eSpark-Backup/anthony-arii-bento-pad/Design Files/Bento Pad Plus V1.0/Schematic/Bento Pad Plus V1.0.pdf

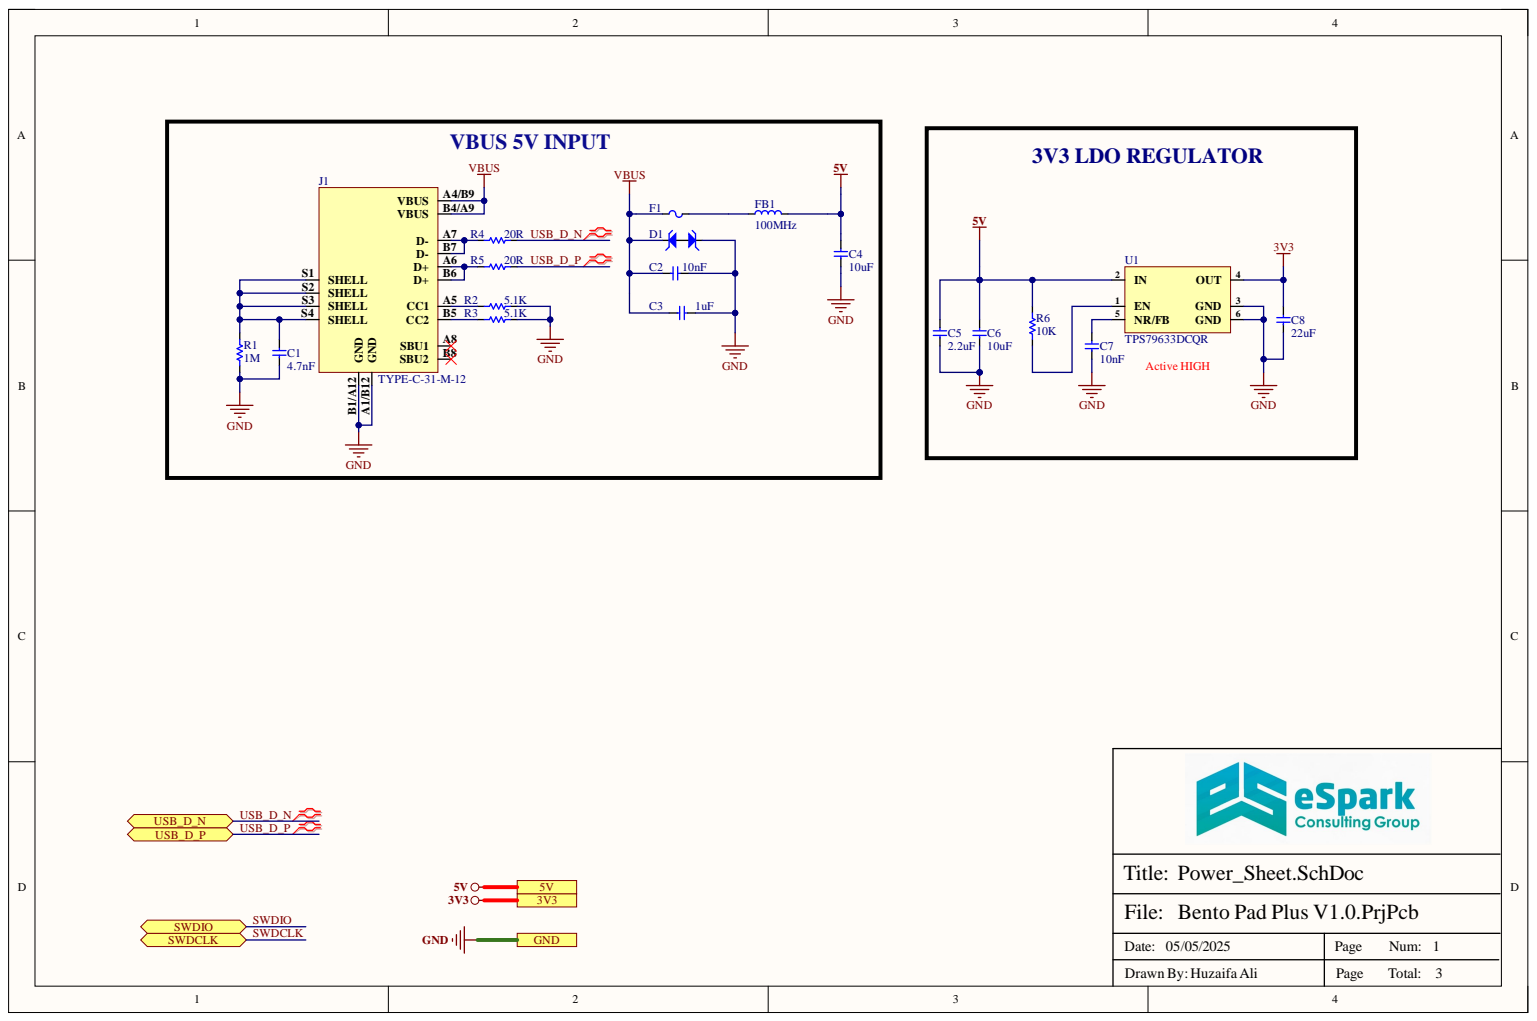
[picture p5: page 1]

Bento Pad Plus V1.0.PrjPcb

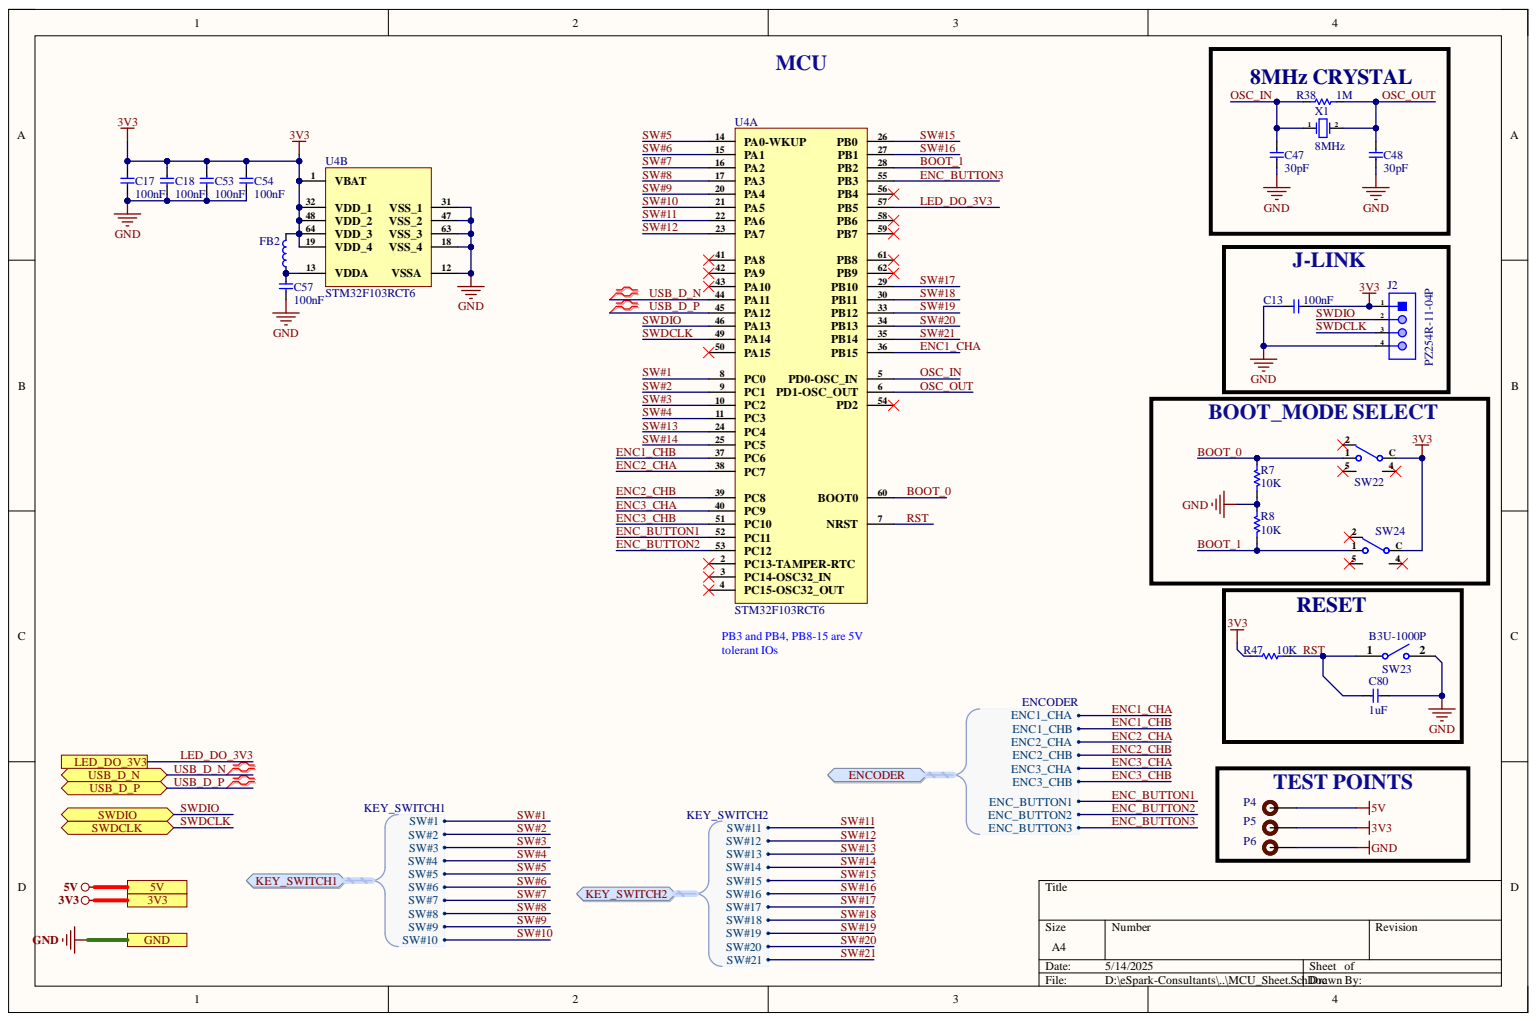
[picture p6: page 2]

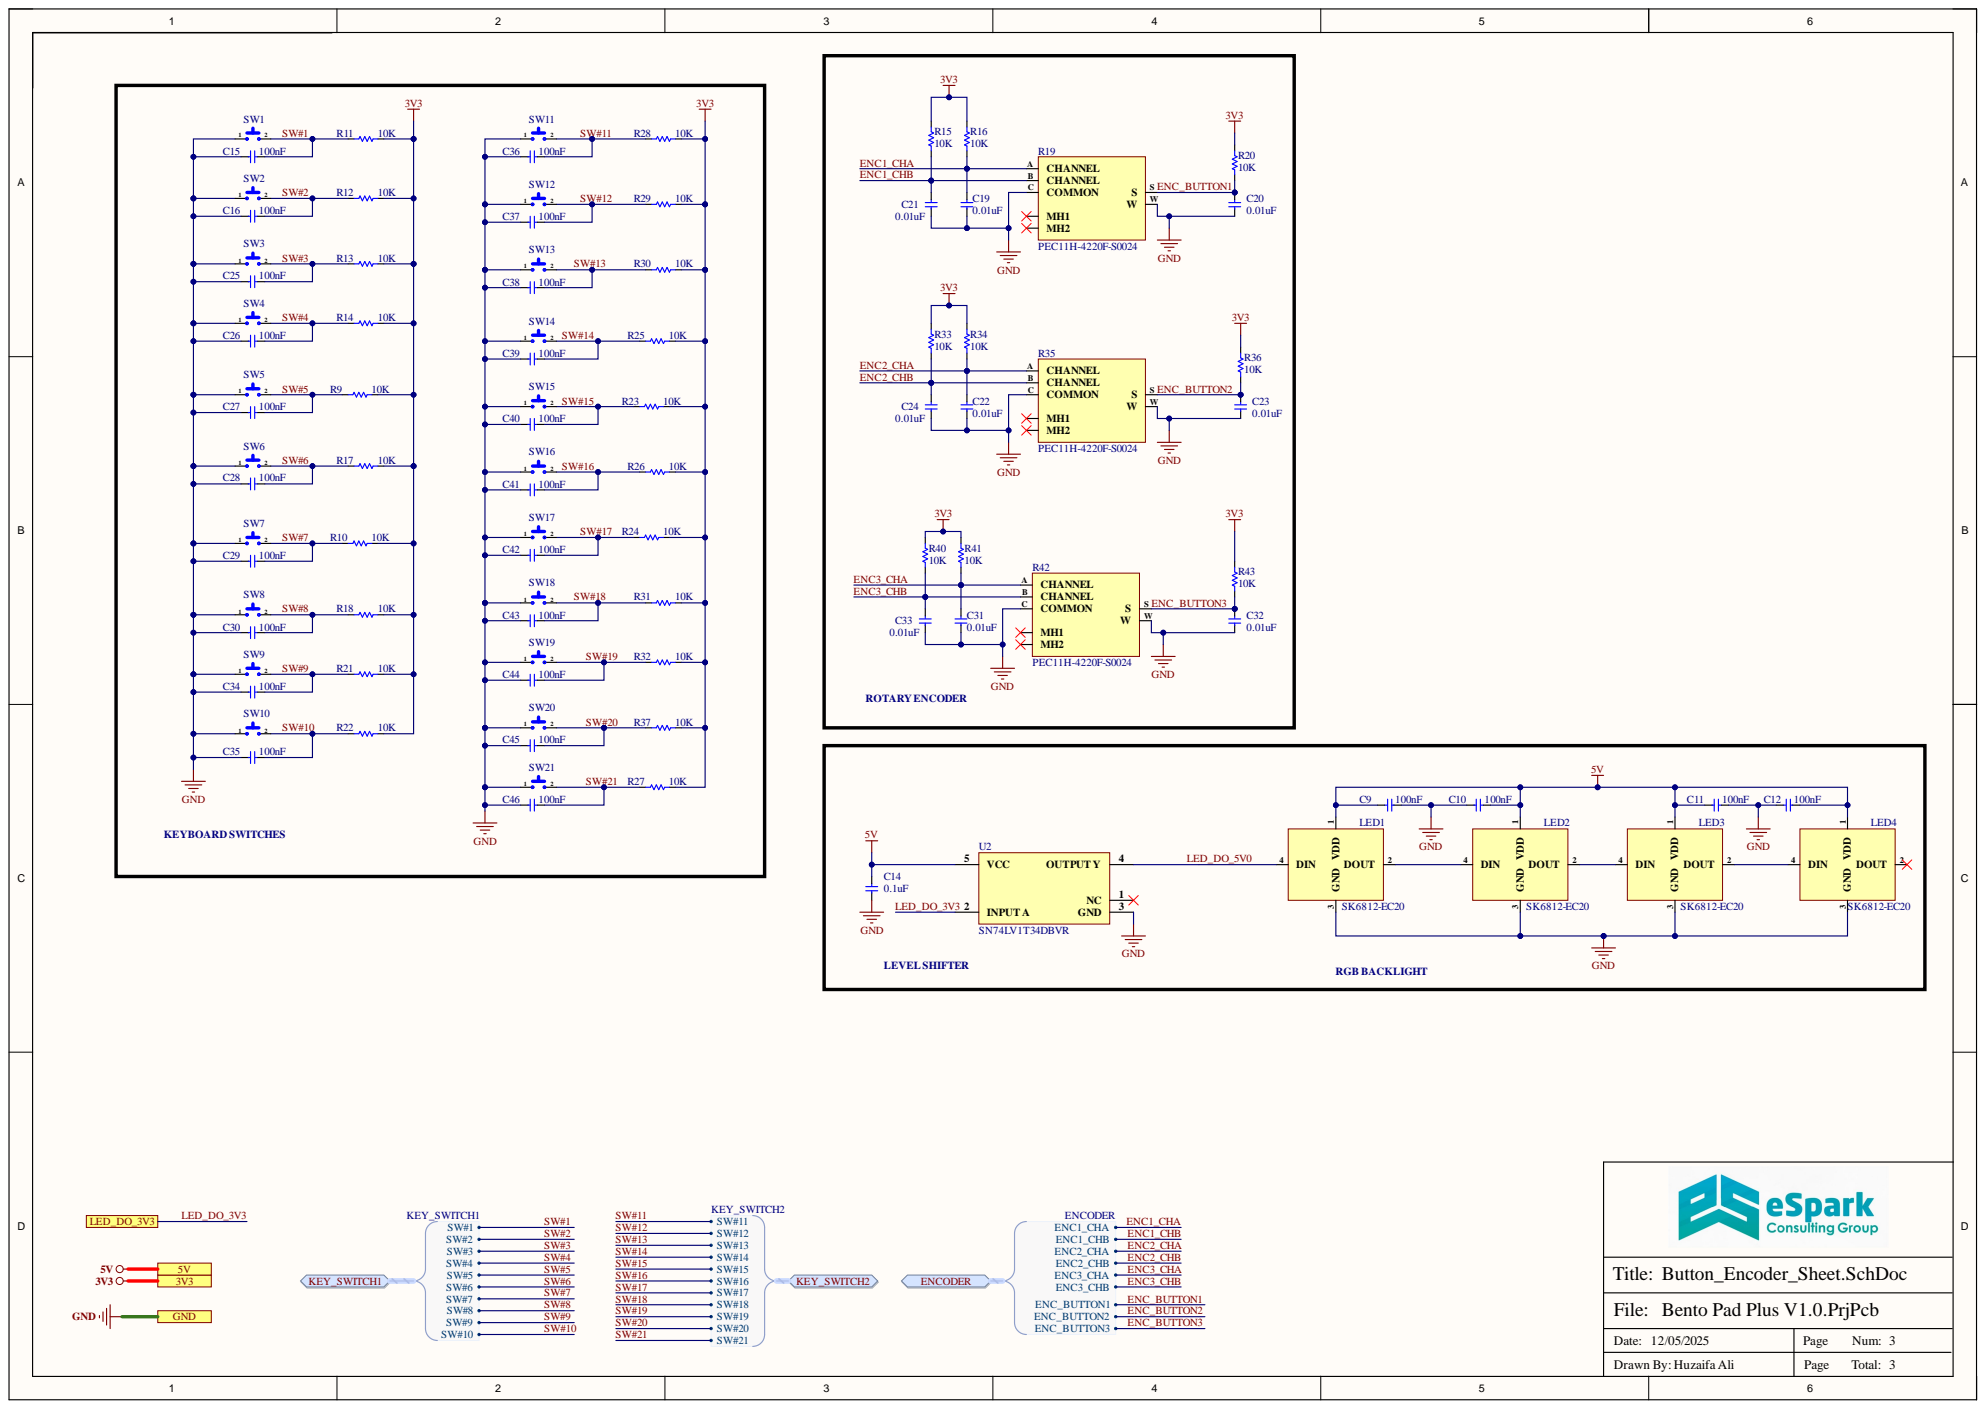
[picture p7: page 3]

Bento Pad Plus V1.0.PrjPcb

Date: 12/05/2025 | Page Num: 3

Drawn By: Huzaifa Ali | Page Total:
