eSpark-Backup/anthony-arii-bento-pad/Design Files/Bento Pad V1.0/Schematic/Bento Pad V1.0.pdf

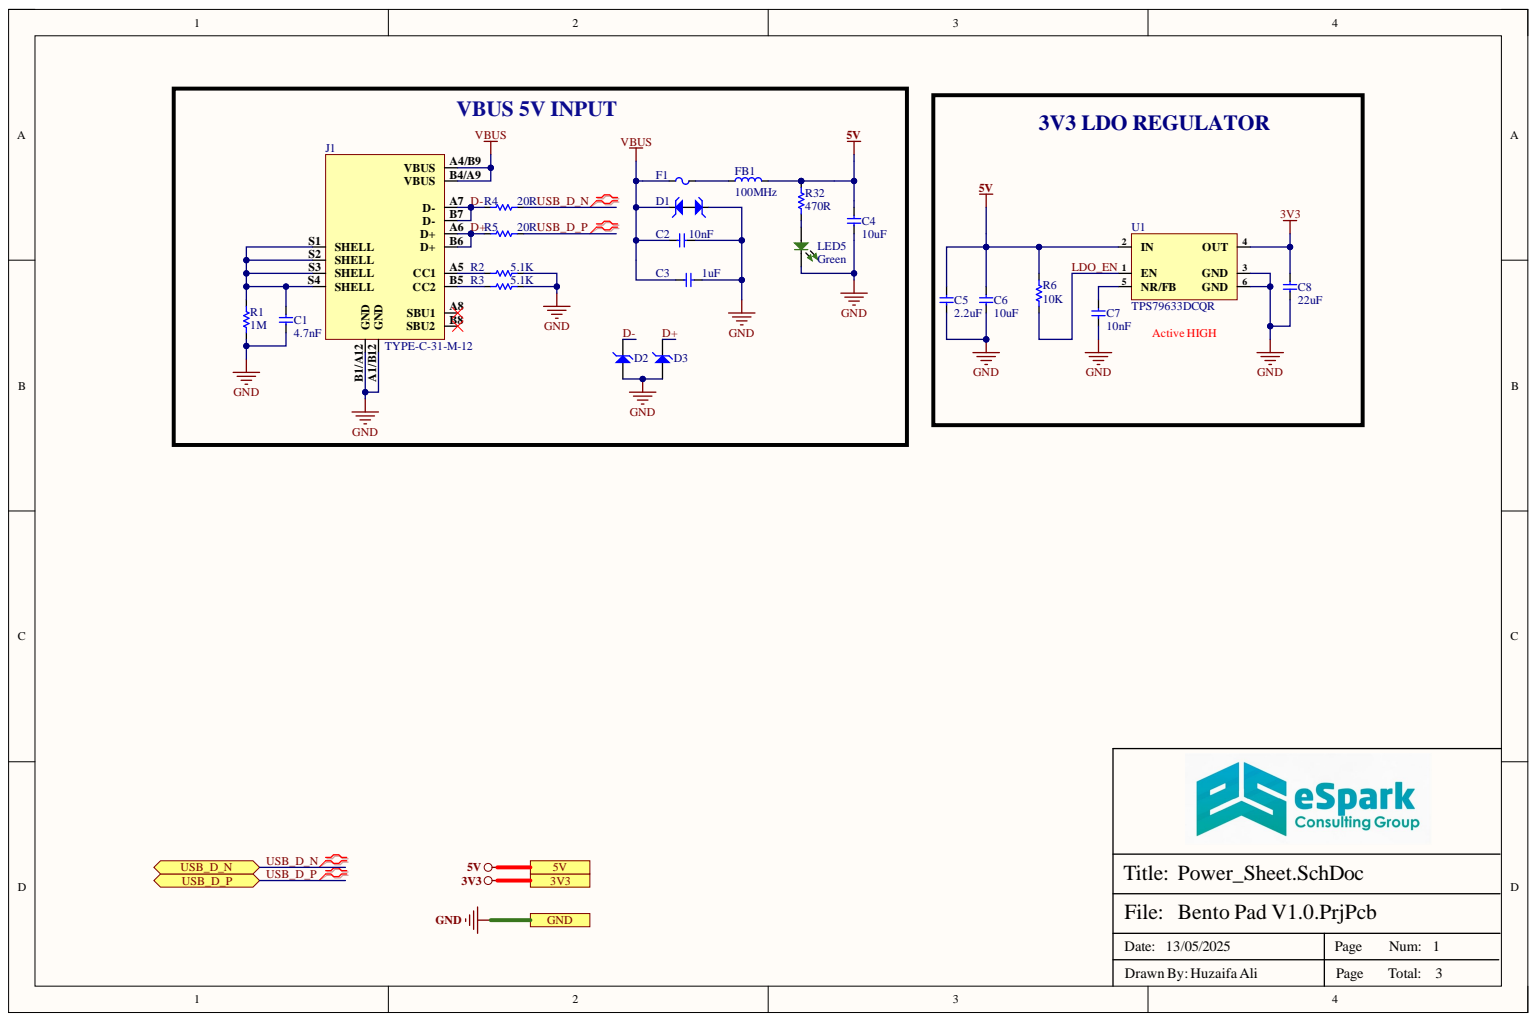
[picture p8: page 1]

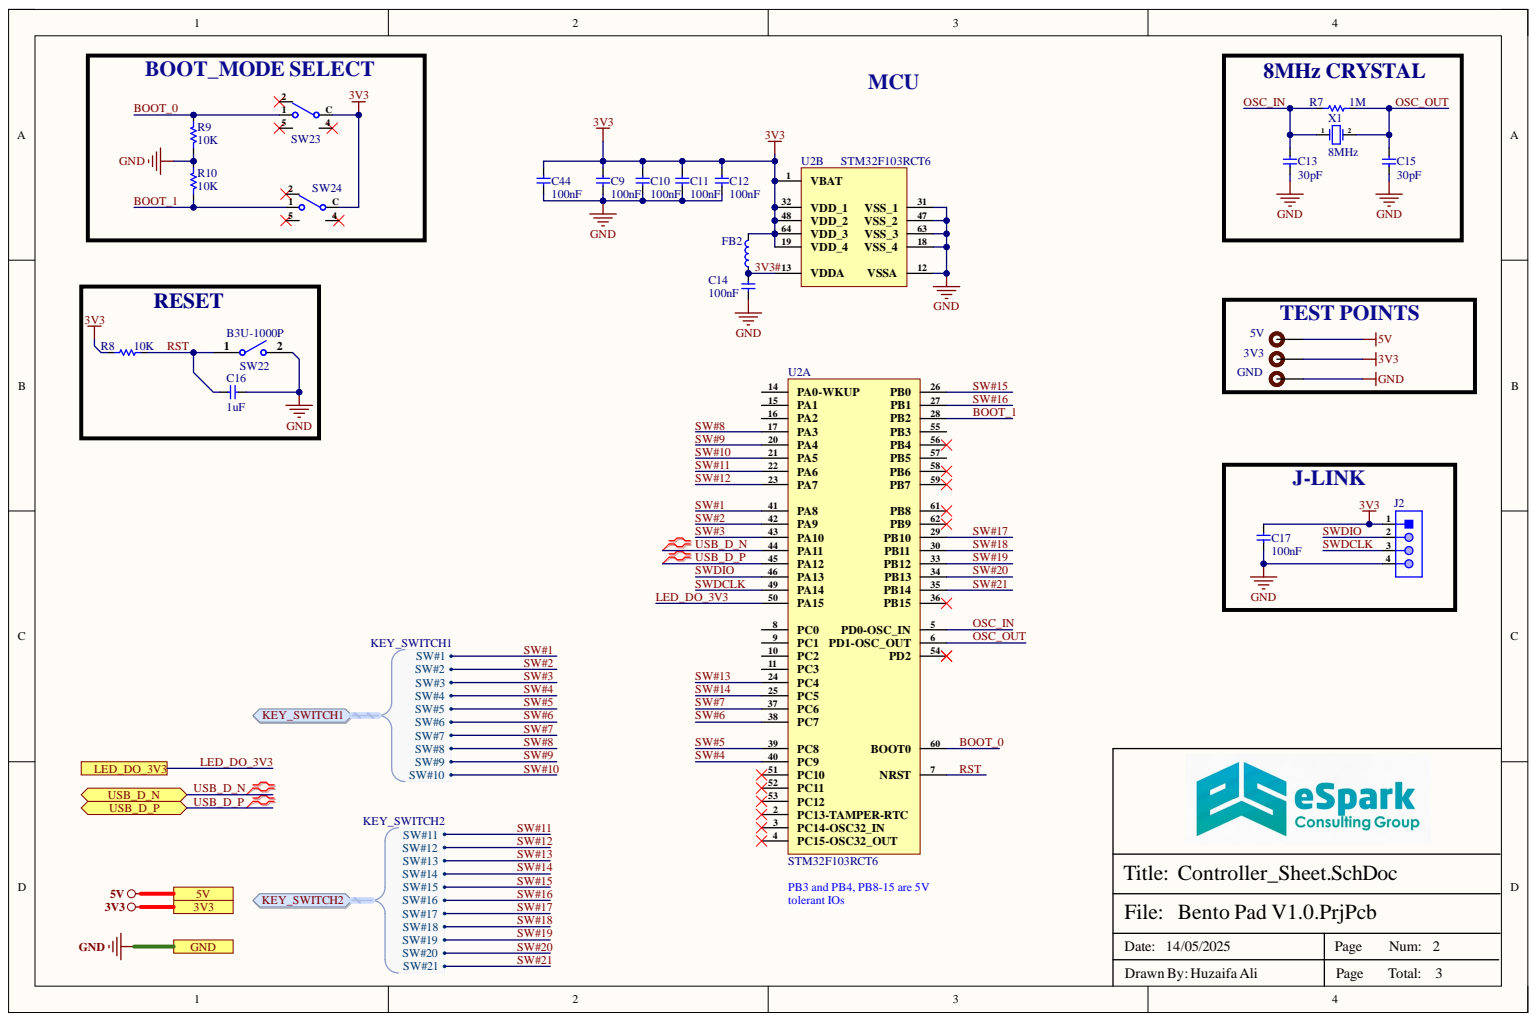
[picture p9: page 2]

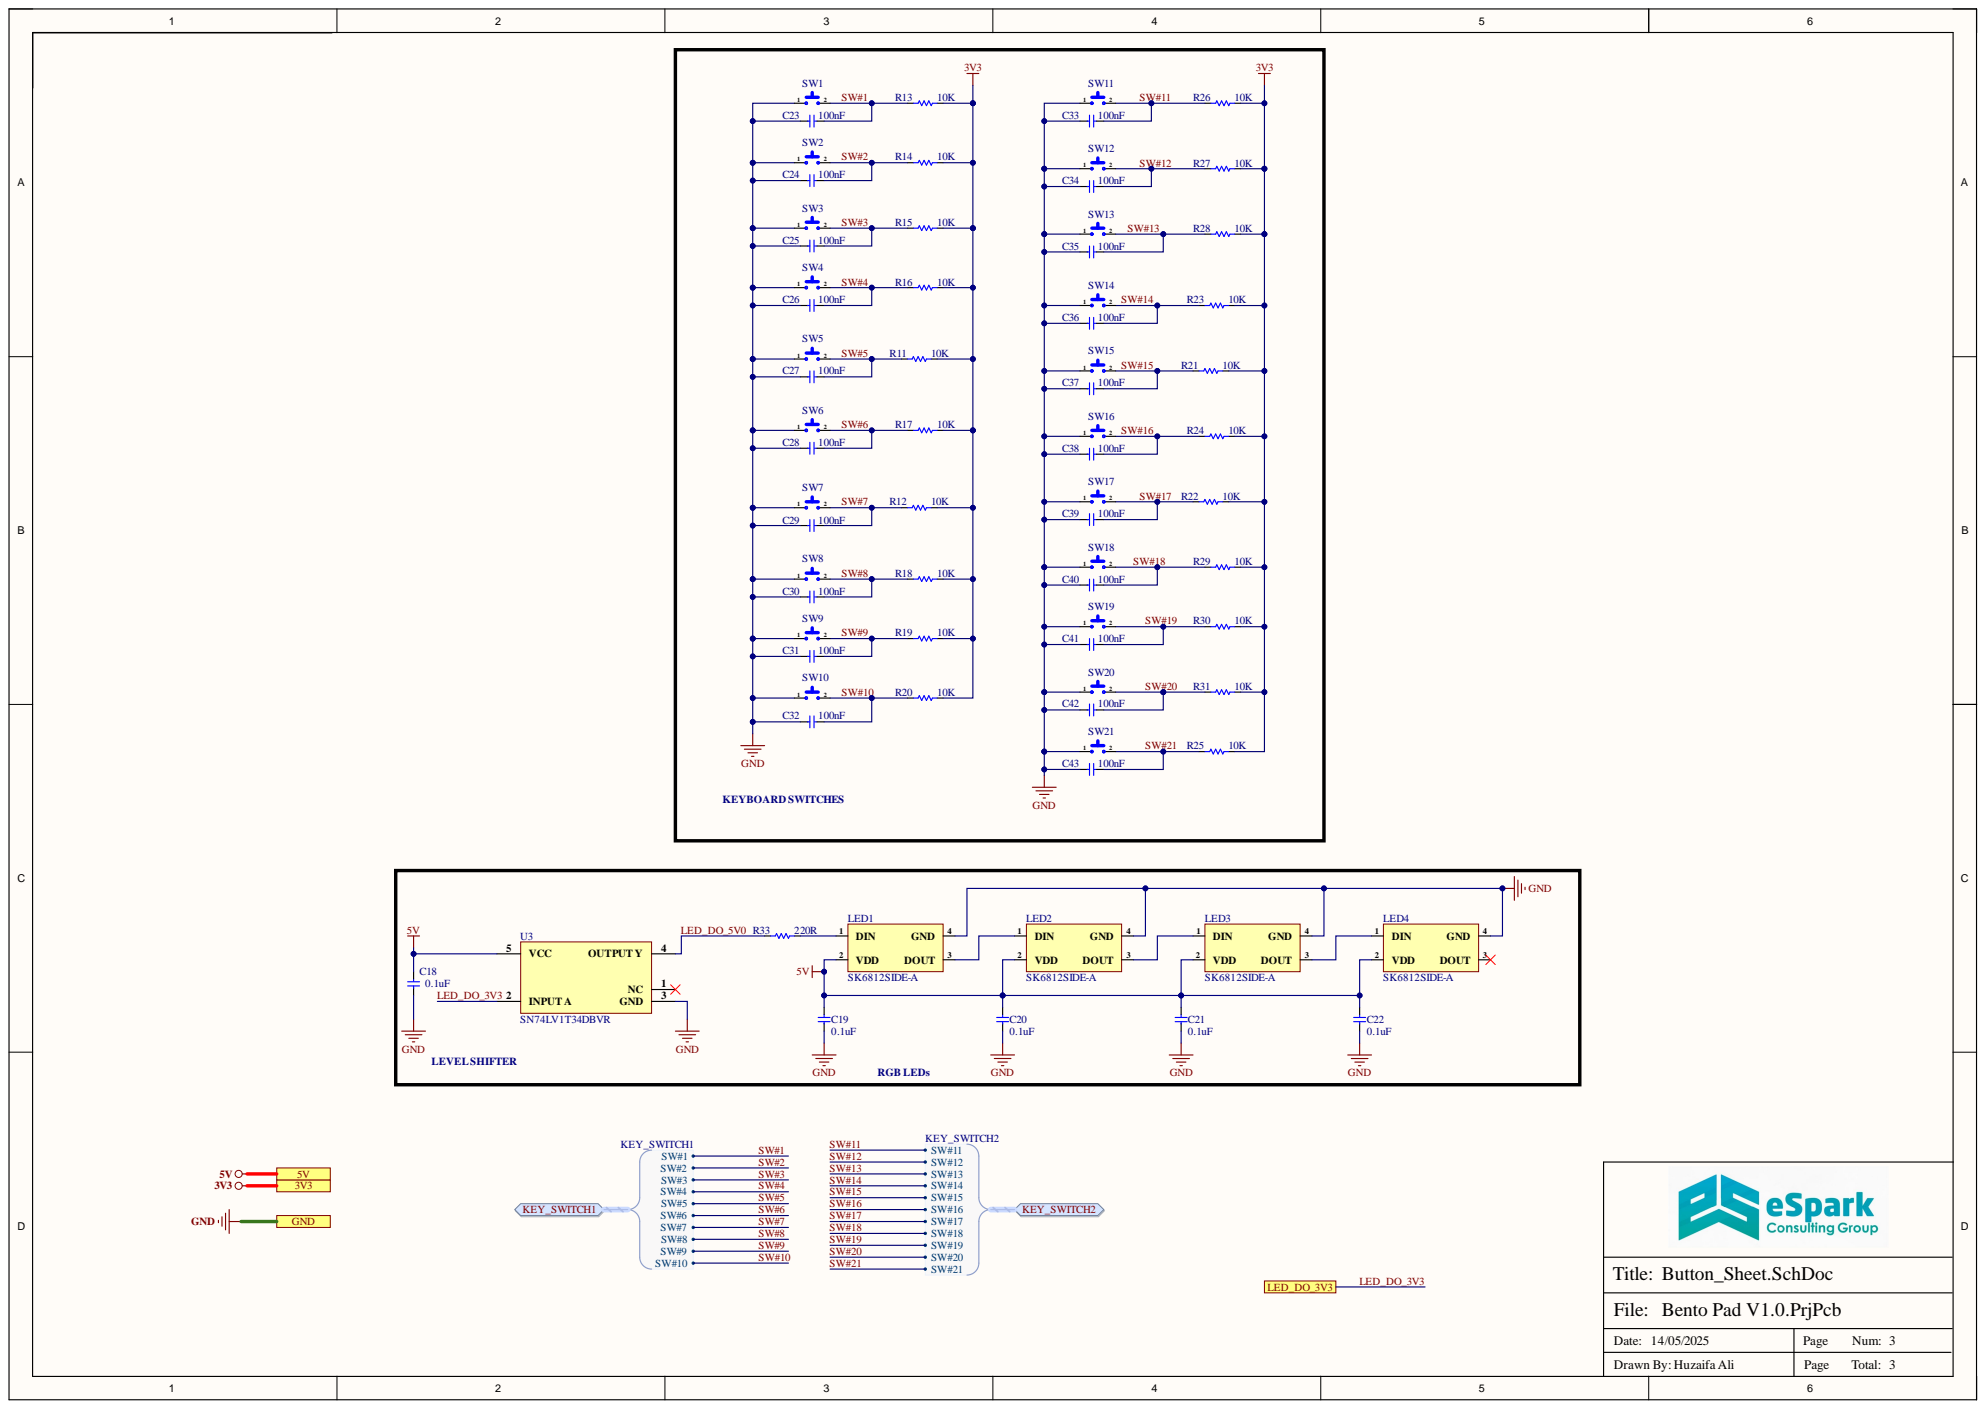
[picture p10: page 3]

Date: 14/05/2025 | Page Num: 3

Drawn By: Huzaifa Ali | Page Total:
