eSpark-Backup/anthony-arii-bento-pad/(list of files, drawings)

Other design files:
Design Files/Bento Pad Mini-v1.0/Bento Pad Mini-v1.0.PrjPcb
Design Files/Bento Pad Mini-v1.0/Bento_Pad_Mini_PCB.PcbDoc
Design Files/Bento Pad Mini-v1.0/Button Sheet.SchDoc
Design Files/Bento Pad Mini-v1.0/Controller_Sheet.SchDoc
Design Files/Bento Pad Mini-v1.0/Power_Sheet.SchDoc
Design Files/Bento Pad Plus V1.0/Bento Pad Plus V1.0.PrjPcb
Design Files/Bento Pad Plus V1.0/Bento_Pad_Plus_PCB.PcbDoc
Design Files/Bento Pad Plus V1.0/Button_Encoder_Sheet.SchDoc
Design Files/Bento Pad Plus V1.0/Controller_Sheet.SchDoc
Design Files/Bento Pad Plus V1.0/Power_Sheet.SchDoc
Design Files/Bento Pad V1.0/Bento Pad V1.0.PrjPcb
Design Files/Bento Pad V1.0/Bento Pad V1.0.PrjPcb
Design Files/Bento Pad V1.0/Bento Pad V1.0_PCB.PcbDoc
Design Files/Bento Pad V1.0/Button_Sheet.SchDoc
Design Files/Bento Pad V1.0/Controller_Sheet.SchDoc
Design Files/Bento Pad V1.0/Power_Sheet.SchDoc
