eSpark-Backup/anthony-arii-bento-pad/(commit log)

2025-04-18 #2 Git ignore and project files added
    [Bento Pad Mini-v1.0.PrjPcb, Power_Sheet.SchDoc]
2025-04-18 #2 Updated schematic design (in progress)
    [Bento Pad Mini-v1.0.PrjPcb, Controller_Sheet.SchDoc, Power_Sheet.SchDoc]
2025-04-21 #2 Updated Power, MCU, Button sheets (done)
    [Bento Pad Mini-v1.0.PrjPcb, Button Sheet.SchDoc, Controller_Sheet.SchDoc, Power_Sheet.SchDoc]
2025-04-22 #2 updated schematic design (bento pad)
    [Bento Pad V1.0.PrjPcb, Button Sheet.SchDoc, Controller_Sheet.SchDoc, Power_Sheet.SchDoc]
2025-04-25 #2 Schematic updated bentopad plus, bento pad
    [Bento Pad Plus V1.0.PrjPcb, Bento Pad V1.0.PrjPcb, Button Sheet.SchDoc, Button_Encoder_Sheet.SchDoc, Button_Sheet.SchDoc, Controller_Sheet.SchDoc, Power_Sheet.SchDoc, RGB_LED_Sheet.SchDoc]
2025-04-25 #2 updated schematic bentopad mini, bento pad, bentopad plus (removed errors, schematic pdf added)
    [Bento Pad Plus V1.0.PrjPcb, Bento Pad V1.0.PrjPcb, Controller_Sheet.SchDoc, Power_Sheet.SchDoc]
2025-04-25 #2 updated schematic design (bento pad plus MCU updated)
    [Bento Pad Plus V1.0.PrjPcb, Bento Pad V1.0.PrjPcb, Button_Encoder_Sheet.SchDoc, Button_Sheet.SchDoc, Controller_Sheet.SchDoc, MCU_Sheet.SchDoc, Power_Sheet.SchDoc]
2025-04-28 #2 updated MCU, updated RGB light section
    [Bento Pad V1.0.PrjPcb, Button_Encoder_Sheet.SchDoc, Button_Sheet.SchDoc, Controller_Sheet.SchDoc, MCU_Sheet.SchDoc, Power_Sheet.SchDoc, RGB_LED_Sheet.SchDoc, RGB_Sheet.SchDoc]
2025-04-29 #2 updated bentopad mini (MCU ) (done)
    [Button Sheet.SchDoc, Controller_Sheet.SchDoc]
2025-04-29 #2 updated schematic design
    [Bento Pad Mini-v1.0.PrjPcb, Bento Pad Plus V1.0.PrjPcb, Bento Pad V1.0.PrjPcb, Bento_Pad_Mini_PCB.PcbDoc, Bento_Pad_Plus_PCB.PcbDoc, Button Sheet.SchDoc, Button_Encoder_Sheet.SchDoc, Button_Sheet.SchDoc]
2025-04-30 #3 Updated PCB component placement
    [Bento_Pad_Mini_PCB.PcbDoc]
2025-05-02 #3 updarted PCB component placement (in progress)
    [Bento_Pad_Mini_PCB.PcbDoc, Controller_Sheet.SchDoc, Power_Sheet.SchDoc]
2025-05-05 #3 updated component placement
    [Bento Pad V1.0.PrjPcb, Bento Pad V1.0_PCB.PcbDoc, Bento_Pad_Mini_PCB.PcbDoc, Button Sheet.SchDoc, Button_Encoder_Sheet.SchDoc, Button_Sheet.SchDoc, Controller_Sheet.SchDoc, MCU_Sheet.SchDoc]
2025-05-06 #3 updated pcb design
    [Bento Pad V1.0_PCB.PcbDoc, Bento_Pad_Mini_PCB.PcbDoc, Controller_Sheet.SchDoc, Power_Sheet.SchDoc]
2025-05-07 #3 Updated PCB design (in progress)
    [Bento_Pad_Mini_PCB.PcbDoc, Button Sheet.SchDoc, Controller_Sheet.SchDoc, Power_Sheet.SchDoc]
2025-05-08 #2 Updated PCB design (in progress)
    [Bento_Pad_Mini_PCB.PcbDoc, Button Sheet.SchDoc, Controller_Sheet.SchDoc, Power_Sheet.SchDoc]
2025-05-09 #4 Updated PCB design
    [Bento Pad V1.0_PCB.PcbDoc, Bento_Pad_Mini_PCB.PcbDoc, Button Sheet.SchDoc, Button_Sheet.SchDoc, Controller_Sheet.SchDoc, Power_Sheet.SchDoc]
2025-05-12 #4 Updated PCB design Bento Pad V1.0
    [Bento Pad Mini-v1.0.PrjPcb, Bento Pad V1.0_PCB.PcbDoc, Bento_Pad_Mini_PCB.PcbDoc, Button Sheet.SchDoc, Button_Encoder_Sheet.SchDoc, Button_Sheet.SchDoc, Controller_Sheet.SchDoc, MCU_Sheet.SchDoc]
2025-05-13 #4 updated PCB design (in progress)
    [Bento Pad Mini-v1.0.PrjPcb, Bento Pad V1.0_PCB.PcbDoc, Bento_Pad_Mini_PCB.PcbDoc, Bento_Pad_Plus_PCB.PcbDoc, Button_Sheet.SchDoc, Controller_Sheet.SchDoc, Power_Sheet.SchDoc]
2025-05-29 #1 Updated Schematic (Added TX, RX pins for debuging)
    [Bento Pad Mini-v1.0.PrjPcb, Bento Pad Plus V1.0.PrjPcb, Button Sheet.SchDoc, Button_Encoder_Sheet.SchDoc, Controller_Sheet.SchDoc, MCU_Sheet.SchDoc, Power_Sheet.SchDoc]
2025-05-30 #3 Updated Bento Pad mini
    [Bento_Pad_Mini_PCB.PcbDoc, Button_Encoder_Sheet.SchDoc]
2025-05-30 #5 In-Progress
    [Bento_Pad_Plus_PCB.PcbDoc]
